tuwuhs/kenobi/vcfvca/kenobi_vcfvca_pcb.png

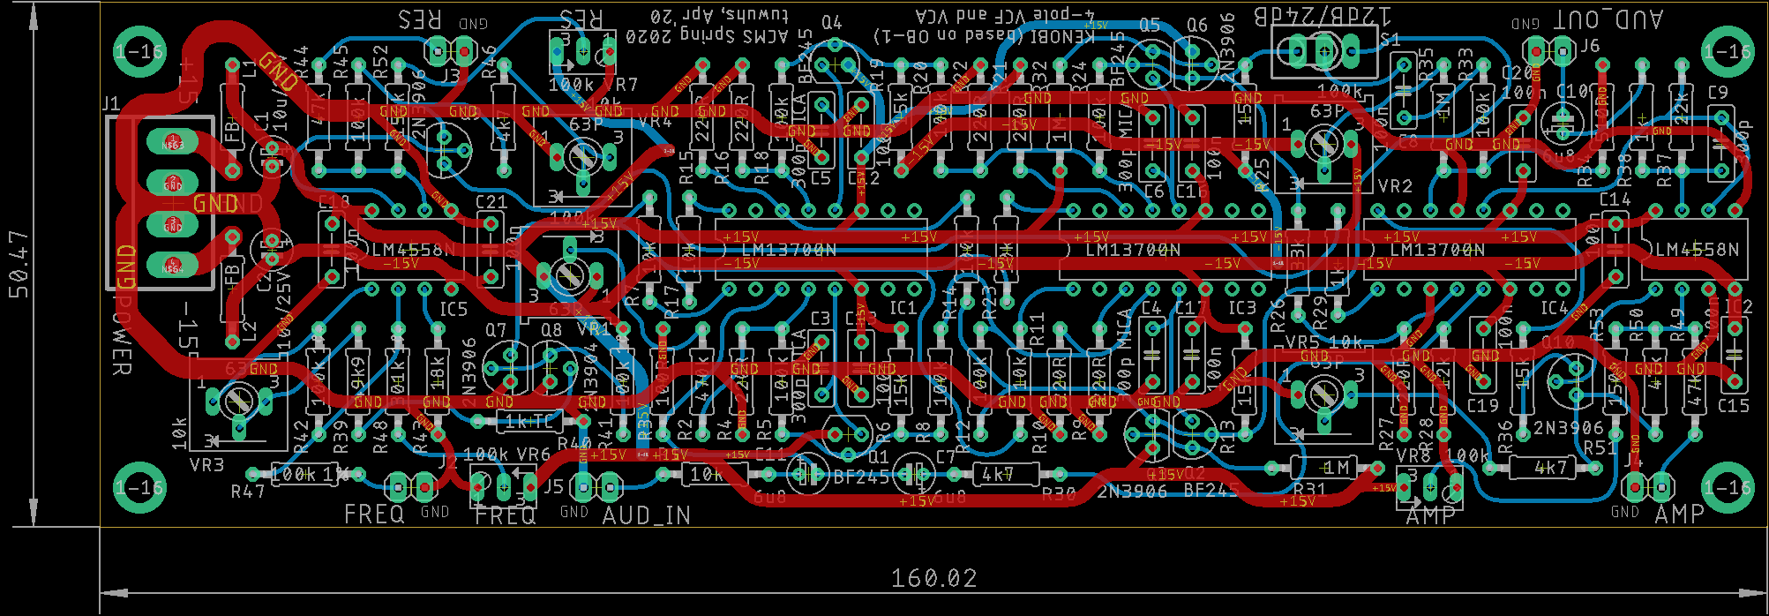
vcfvca/kenobi_vcfvca_pcb.png
