tuwuhs/kenobi/vcfvca/kenobi_vcfvca_sch.png

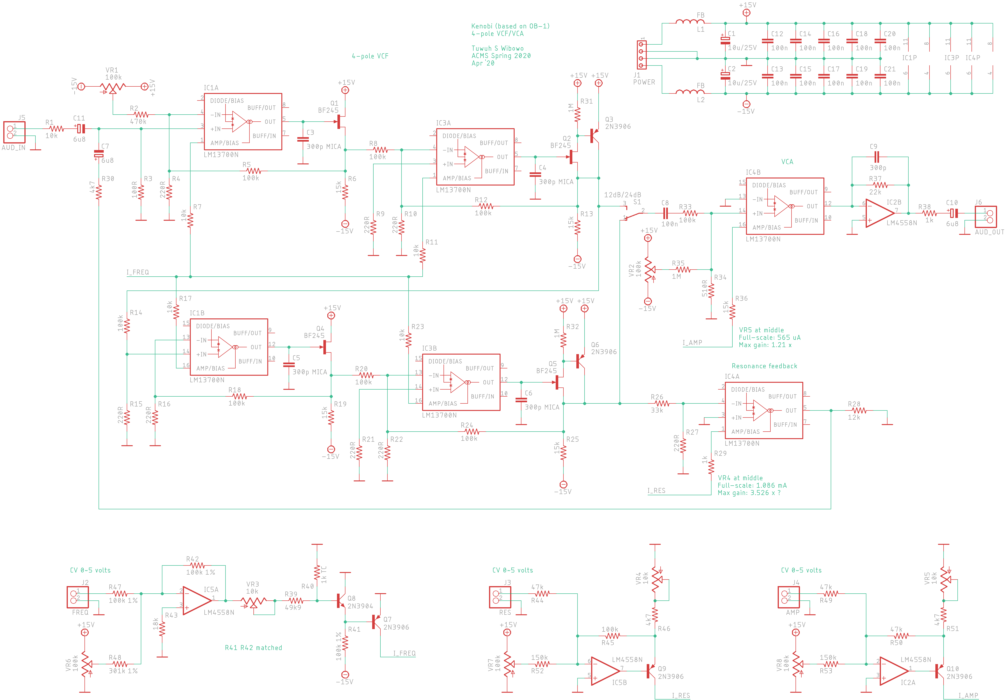
vcfvca/kenobi_vcfvca_sch.png
