tuwuhs/kenobi/vcfvca/layout.png

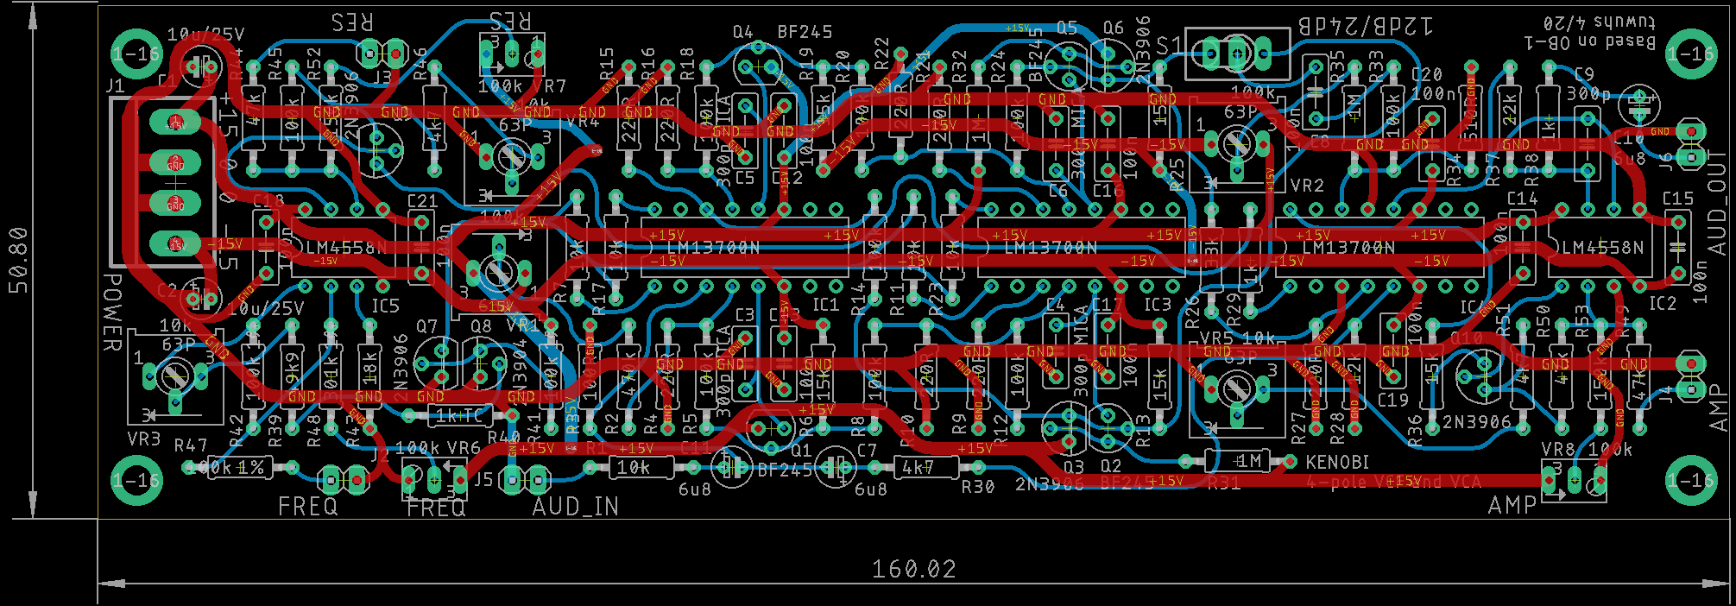
vcfvca/layout.png
