tuwuhs/kenobi/vcfvca/placement.png

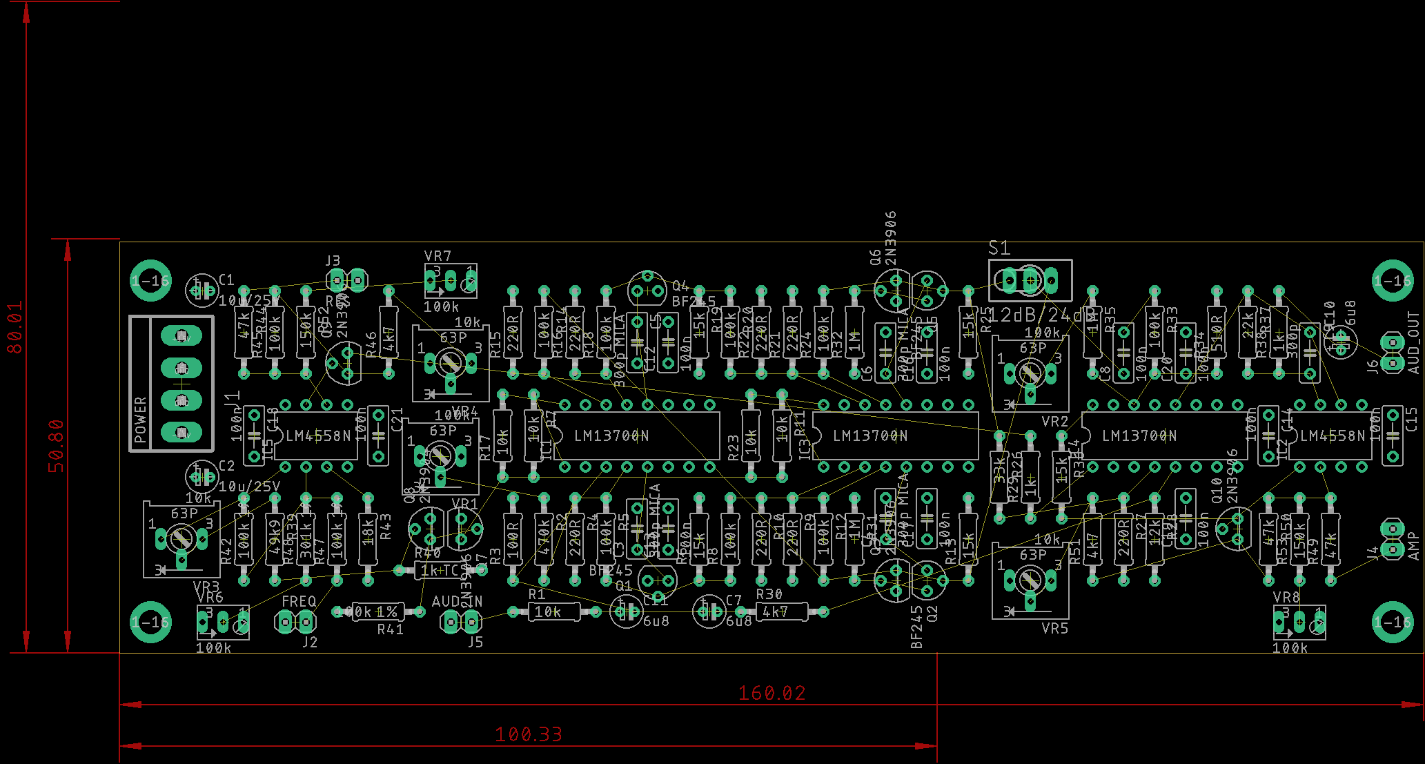
vcfvca/placement.png
