tuwuhs/kenobi/vcfvca/vcfvca.pdf

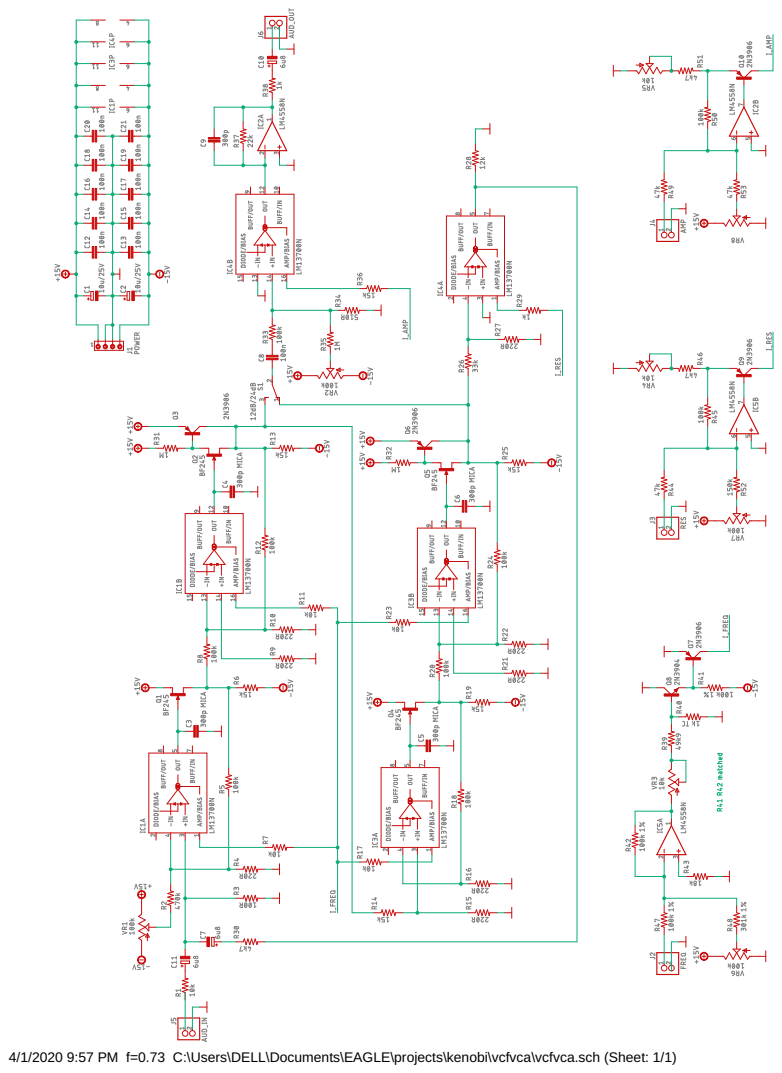
[picture p5: page 1]

4/1/2020 9:57 PM f=0.73 C:\Users\DELL\Documents\EAGLE\projects\kenobi\vcfvca\vcfvca.sch (Sheet: 1/1)
