tuwuhs/kenobi/vcfvca/vcfvca.brd

## EAGLE design vcfvca/vcfvca.brd (2020-04-23)

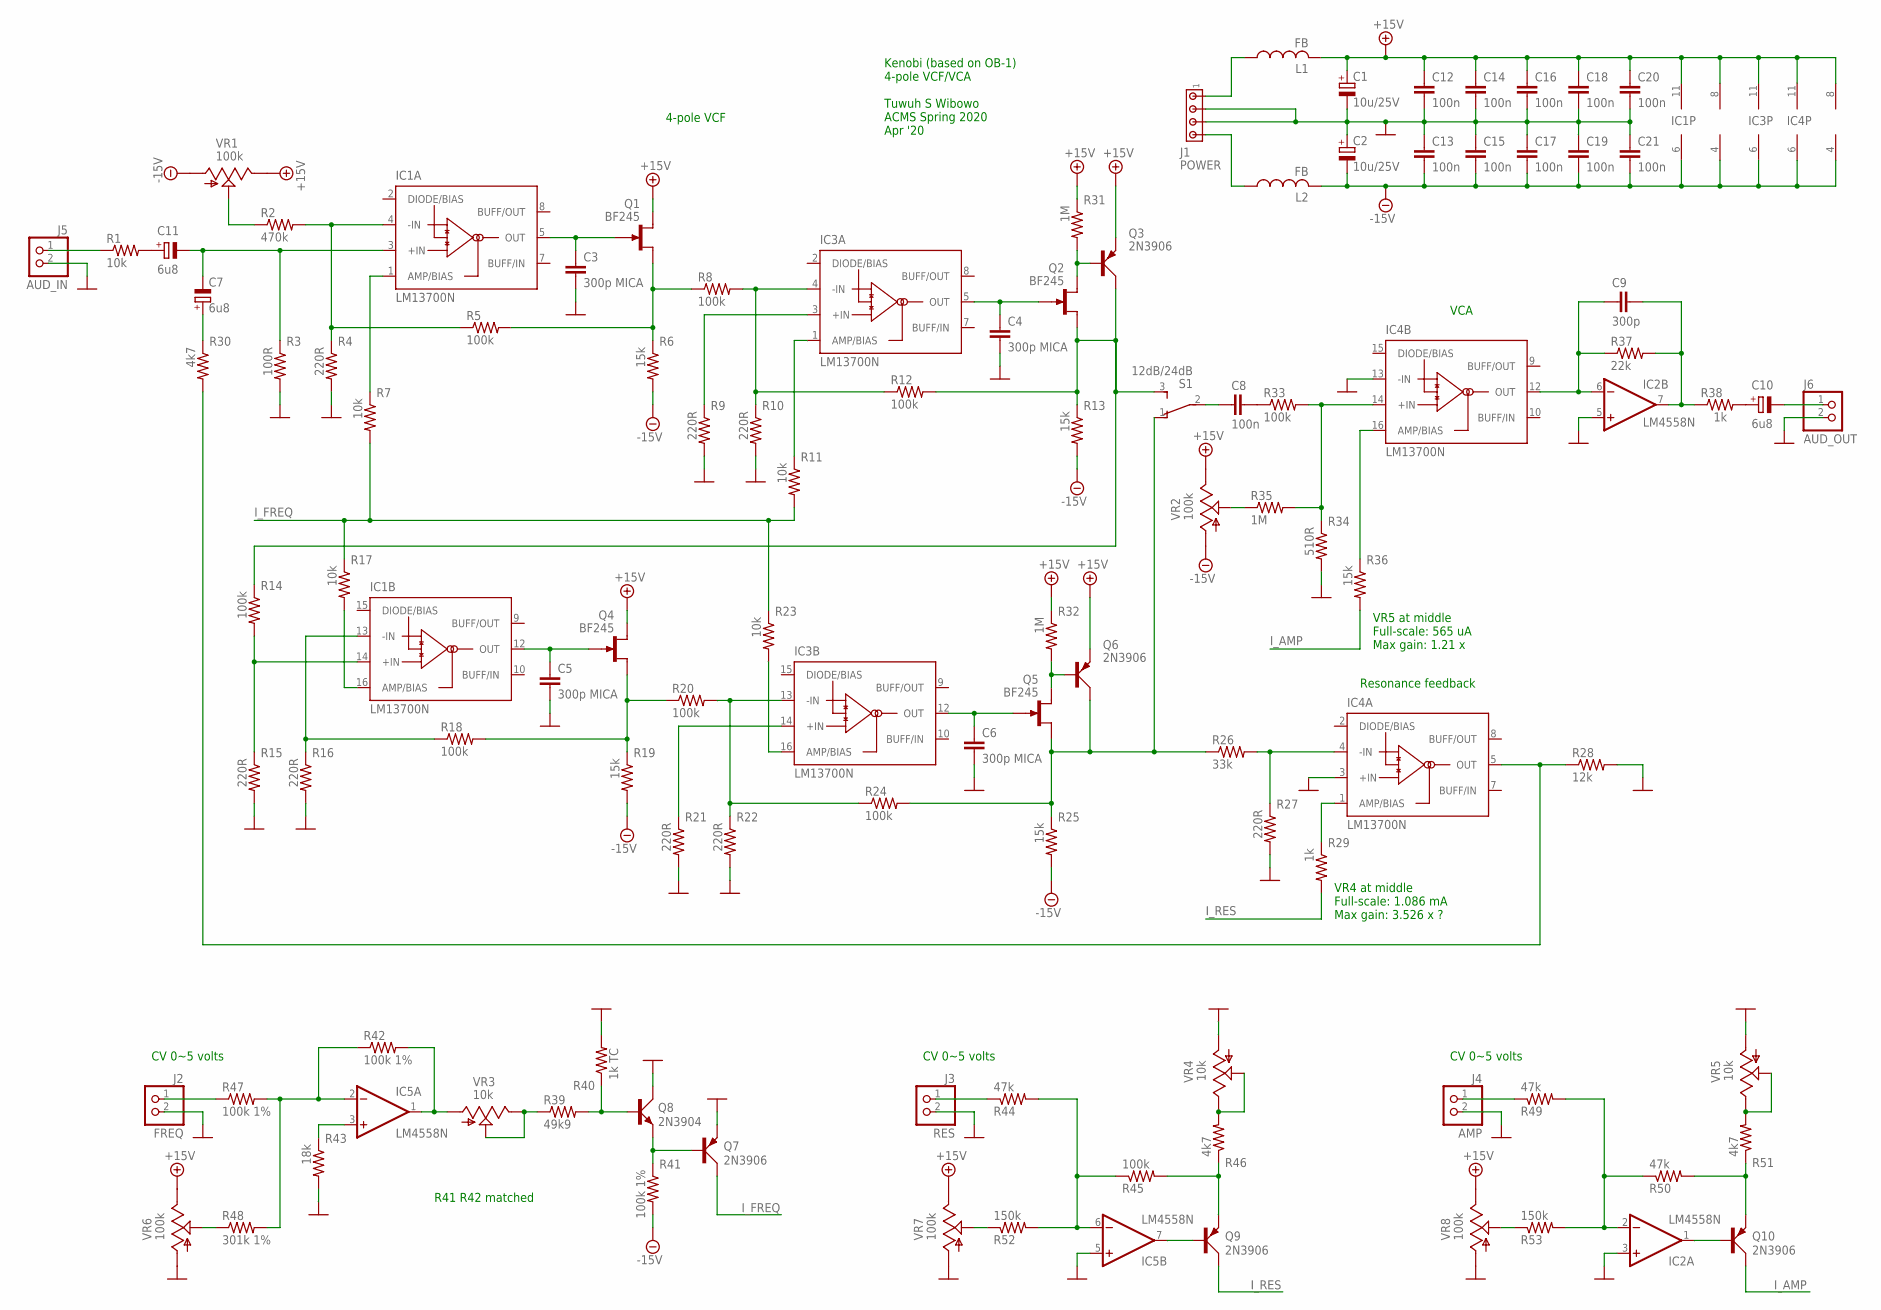
[picture p6: schematic vcfvca.sch]

Parts:
C1, C2: 10u/25V; E1,8-4
C3, C4, C5, C6: 300p MICA; C050-025X075
C7, C10, C11: 6u8; E1,8-4
C8, C12, C13, C14, C15, C16, C17, C18, C19, C20, C21: 100n; C050-025X075
C9: 300p; C050-025X075
IC1, IC3, IC4: LM13700N; DIL16
IC2, IC5: LM4558N; DIL08
J1: POWER; 1X4MTA
J2: FREQ; 1X02
J3: RES; 1X02
J4: AMP; 1X02
J5: AUD_IN; 1X02
J6: AUD_OUT; 1X02
L1, L2: FB; 0207/10
Q1, Q2, Q4, Q5: BF245; SOT54C
Q3, Q6, Q7, Q9, Q10: 2N3906; TO92D
Q8: 2N3904; TO92D
R1, R7, R11, R17, R23: 10k; 0207/10
R2: 470k; 0207/10
R3: 100R; 0207/10
R4, R9, R10, R15, R16, R21, R22, R27: 220R; 0207/10
R5, R8, R12, R14, R18, R20, R24, R33, R45: 100k; 0207/10
R6, R13, R19, R25, R36: 15k; 0207/10
R26: 33k; 0207/10
R28: 12k; 0207/10
R29, R38: 1k; 0207/10
R30, R46, R51: 4k7; 0207/10
R31, R32, R35: 1M; 0207/10
R34: 510R; 0207/10
R37: 22k; 0207/10
R39: 49k9; 0207/10
R40: 1k TC; 0207/10
R41, R42, R47: 100k 1%; 0207/10
R43: 18k; 0207/10
R44, R49, R50: 47k; 0207/10
R48: 301k 1%; 0207/10
R52, R53: 150k; 0207/10
S1: 12dB/24dB; TL3XPO
VR1, VR2: 100k; S63P
VR3, VR4, VR5: 10k; S63P
VR6, VR7, VR8: 100k; B64Y

Connections:
+15V: C1.+, C12.1, C14.1, C16.1, C18.1, C20.1, IC1.11 (V+), IC2.8 (V+), IC3.11 (V+), IC4.11 (V+), IC5.8 (V+), L1.2, Q1.D, Q3.E, Q4.D, Q6.E, R31.1, R32.1, VR1.E, VR2.E, VR6.E, VR7.E, VR8.E
-15V: C2.-, C13.2, C15.2, C17.2, C19.2, C21.2, IC1.6 (V-), IC2.4 (V-), IC3.6 (V-), IC4.6 (V-), IC5.4 (V-), L2.2, R6.2, R13.2, R19.2, R25.2, R41.2, VR1.A, VR2.A
GND: C1.-, C2.+, C3.2, C4.2, C5.2, C6.2, C12.2, C13.1, C14.2, C15.1, C16.2, C17.1, C18.2, C19.1, C20.2, C21.1, IC2.3 (+IN), IC2.5 (+IN), IC4.3 (+IN), IC4.13 (-IN), IC5.5 (+IN), J1.2, J1.3, J2.2, J3.2, J4.2, J5.2, J6.2, Q7.E, Q8.C, R3.2, R4.2, R9.2, R10.2, R15.2, R16.2, R21.2, R22.2, R27.2, R28.2, R34.2, R40.2, R43.2, VR4.A, VR5.A, VR6.A, VR7.A, VR8.A
I_AMP: Q10.C, R36.2
I_FREQ: Q7.C, R7.2, R11.2, R17.1, R23.1
I_RES: Q9.C, R29.2
unnamed: C4.1, IC3.5 (OUT), Q2.G
unnamed: C3.1, IC1.5 (OUT), Q1.G
unnamed: C5.1, IC1.12 (OUT), Q4.G
unnamed: C6.1, IC3.12 (OUT), Q5.G
unnamed: IC1.4 (-IN), R2.2, R4.1, R5.1
unnamed: IC1.1 (AMP/BIAS), R7.1
unnamed: Q1.S, R5.2, R6.1, R8.1
unnamed: C7.-, C11.-, IC1.3 (+IN), R3.1
unnamed: IC3.1 (AMP/BIAS), R11.1
unnamed: IC3.3 (+IN), R9.1
unnamed: IC3.4 (-IN), R8.2, R10.1, R12.1
unnamed: C7.+, R30.1
unnamed: IC1.14 (+IN), R14.2, R15.1
unnamed: IC1.13 (-IN), R16.1, R18.1
unnamed: IC4.4 (-IN), R26.2, R27.1
unnamed: Q4.S, R18.2, R19.1, R20.1
unnamed: Q2.S, Q3.C, R12.2, R13.1, R14.1, S1.3 (S)
unnamed: Q5.S, Q6.C, R24.2, R25.1, R26.1, S1.1 (O)
unnamed: IC3.13 (-IN), R20.2, R22.1, R24.1
unnamed: IC3.14 (+IN), R21.1
unnamed: IC4.1 (AMP/BIAS), R29.1
unnamed: IC1.16 (AMP/BIAS), R17.2
unnamed: IC3.16 (AMP/BIAS), R23.2
unnamed: IC4.5 (OUT), R28.1, R30.2
unnamed: Q5.D, Q6.B, R32.2
unnamed: Q2.D, Q3.B, R31.2
unnamed: C8.1, S1.2
unnamed: C8.2, R33.1
unnamed: IC4.14 (+IN), R33.2, R34.1, R35.2
unnamed: C9.1, IC2.6 (-IN), IC4.12 (OUT), R37.1
unnamed: R35.1, VR2.S
unnamed: IC4.16 (AMP/BIAS), R36.1
unnamed: R2.1, VR1.S
unnamed: C9.2, IC2.7 (OUT), R37.2, R38.1
unnamed: C10.+, R38.2
unnamed: C11.+, R1.2
unnamed: IC5.1 (OUT), R42.2, VR3.A
unnamed: R39.1, VR3.E, VR3.S
unnamed: Q8.B, R39.2, R40.1
unnamed: IC5.3 (+IN), R43.1
unnamed: IC5.2 (-IN), R42.1, R47.2, R48.2
unnamed: Q7.B, Q8.E, R41.1
unnamed: R46.2, VR4.E, VR4.S
unnamed: R51.2, VR5.E, VR5.S
unnamed: Q9.E, R45.2, R46.1
unnamed: IC5.7 (OUT), Q9.B
unnamed: IC5.6 (-IN), R44.2, R45.1, R52.2
unnamed: Q10.E, R50.2, R51.1
unnamed: IC2.1 (OUT), Q10.B
unnamed: J2.1, R47.1
unnamed: IC2.2 (-IN), R49.2, R50.1, R53.2
unnamed: J4.1, R49.1
unnamed: R48.1, VR6.S
unnamed: J5.1, R1.1
unnamed: J3.1, R44.1
unnamed: C10.-, J6.1
unnamed: R52.1, VR7.S
unnamed: R53.1, VR8.S
unnamed: J1.1, L1.1
unnamed: J1.4, L2.1

Notes on the sheet:
R41 R42 matched
CV 0~5 volts
VR5 at middle Full-scale: 565 uA Max gain: 1.21 x
VR4 at middle Full-scale: 1.086 mA Max gain: 3.526 x ?
4-pole VCF
VCA
Resonance feedback
Kenobi (based on OB-1) 4-pole VCF/VCA Tuwuh S Wibowo ACMS Spring 2020 Apr '20

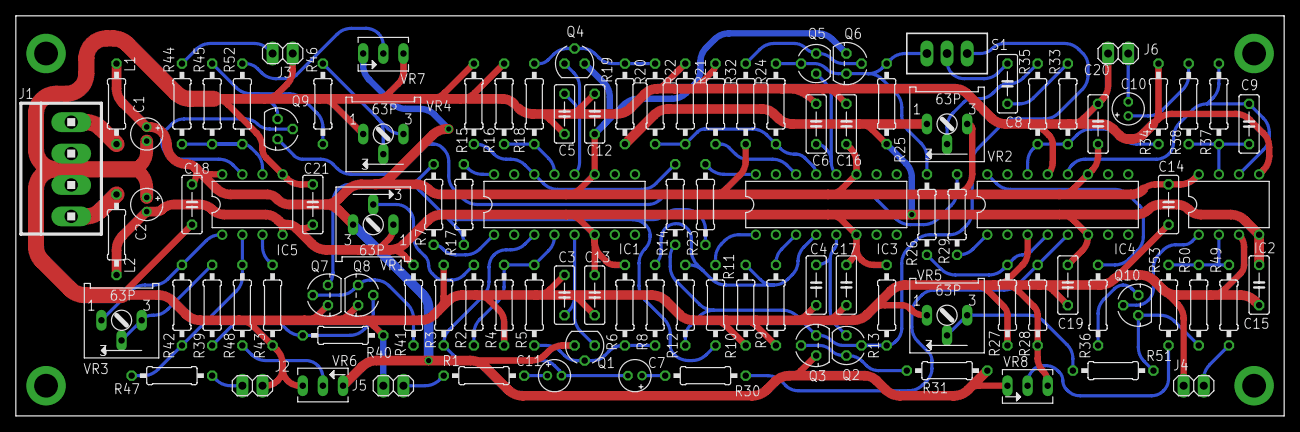
[picture p7: board vcfvca.brd from above]

Board: 2 copper layers, 160.0 x 50.5 mm, 106 parts (0 on the bottom side), 66 nets.
