tuwuhs/kenobi/(commit log)

2020-04-01 Draw schematics for the filter and VCA, excluding control
    [vcfvca.sch]
2020-04-01 Minor changes
    [vcfvca.sch]
2020-04-01 Add VCF freq and res control current generator
    [vcfvca.sch]
2020-04-02 Add circuit analysis writeup
2020-04-02 Finished drawing the schematics. Adapted RES current source for AMP.
    [vcfvca.sch]
2020-04-02 Run and approve ERC
    [vcfvca.sch]
2020-04-02 Fix VCA scale and feedback resistor
    [vcfvca.sch]
2020-04-02 Minor tweak
    [vcfvca.sch]
2020-04-02 Fix component value. Export to image
    [vcfvca.sch]
2020-04-02 Generate PCB file
    [vcfvca.brd]
2020-04-02 Start board placement
    [vcfvca.brd, vcfvca.sch]
2020-04-02 Done placement
    [vcfvca.brd, vcfvca.sch]
2020-04-02 Routed the signals
    [vcfvca.brd, vcfvca.sch]
2020-04-02 Finsihed routing!
    [vcfvca.brd]
2020-04-02 Clear DRC errors
    [vcfvca.brd]
2020-04-03 Tidy up overlay
    [vcfvca.brd]
2020-04-03 Add signature, done! (for now)
    [vcfvca.brd]
2020-04-03 Minor fixes. Add images.
    [vcfvca.brd]
2020-04-03 Minor fixes
    [vcfvca.brd]
2020-04-21 Add ferrite bead, reroute
    [vcfvca.brd, vcfvca.sch]
2020-04-22 Clean up routing
    [vcfvca.brd]
2020-04-22 Move PCB to 0,0
    [vcfvca.brd]
2020-04-22 Export images
    [vcfvca.sch]
2020-04-23 VCF/VCA: revision for final submission
    [vcfvca.brd, vcfvca.sch]
